AIAA-UTD-Comet-Rocketry/flight_tracker_RFM69/PCB docs/trackerPCB.step

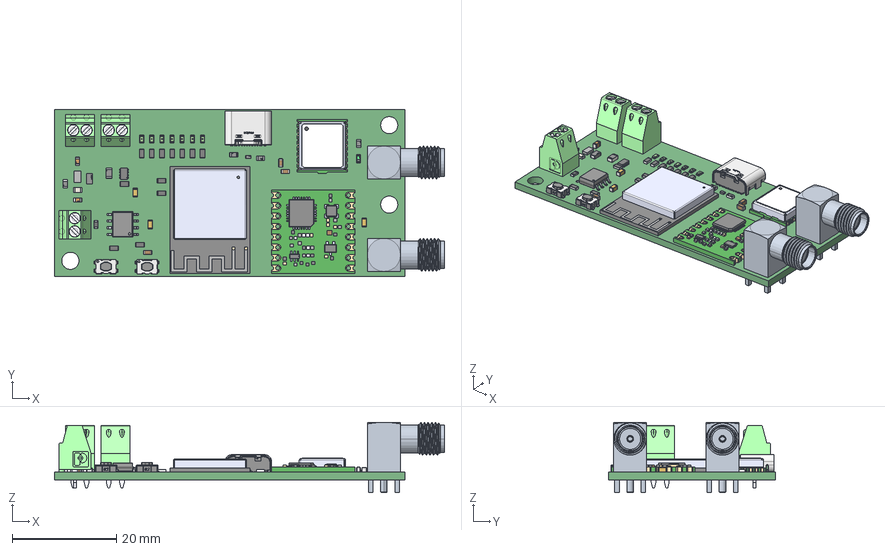
[picture p1: CAD file, 2026-07-08]
PCB docs/trackerPCB.step
74.9 x 32.1 x 13.5 mm
Stackpole Electronics Logo
Mid_Body x 12
Mark x 12
Texas Logo Yury
Texas Logo Yury - Copy
Notch
Molex
terminals x 4
logo x 4
top x 9
RFM69HCW-315S2--3DModel-STEP-56544
PinsArrayLR
pin 1 x 2
shield x 2
base x 2
Stackpole Logo adjustable
RES0603
Murata Logo 3
mpt_0.5-2-2.54 x 3
pcb x 7
lead x 7
lead -notch x 7
mark x 7
mark2 x 7
mark3 x 7
emitter x 7
CAPC1608X95N EIA 0603 x 3
Extruded x 4
ESP32-S3-MINI-1-N8
Sides
Core
Top
Vishay Logo
Pins
Murata logo 1mm
Cap_AVX_06036D476MAT2A_eec x 8
