AIAA-UTD-Comet-Rocketry/flight_tracker_RFM69/PCB docs/PDF/Schematic.PDF

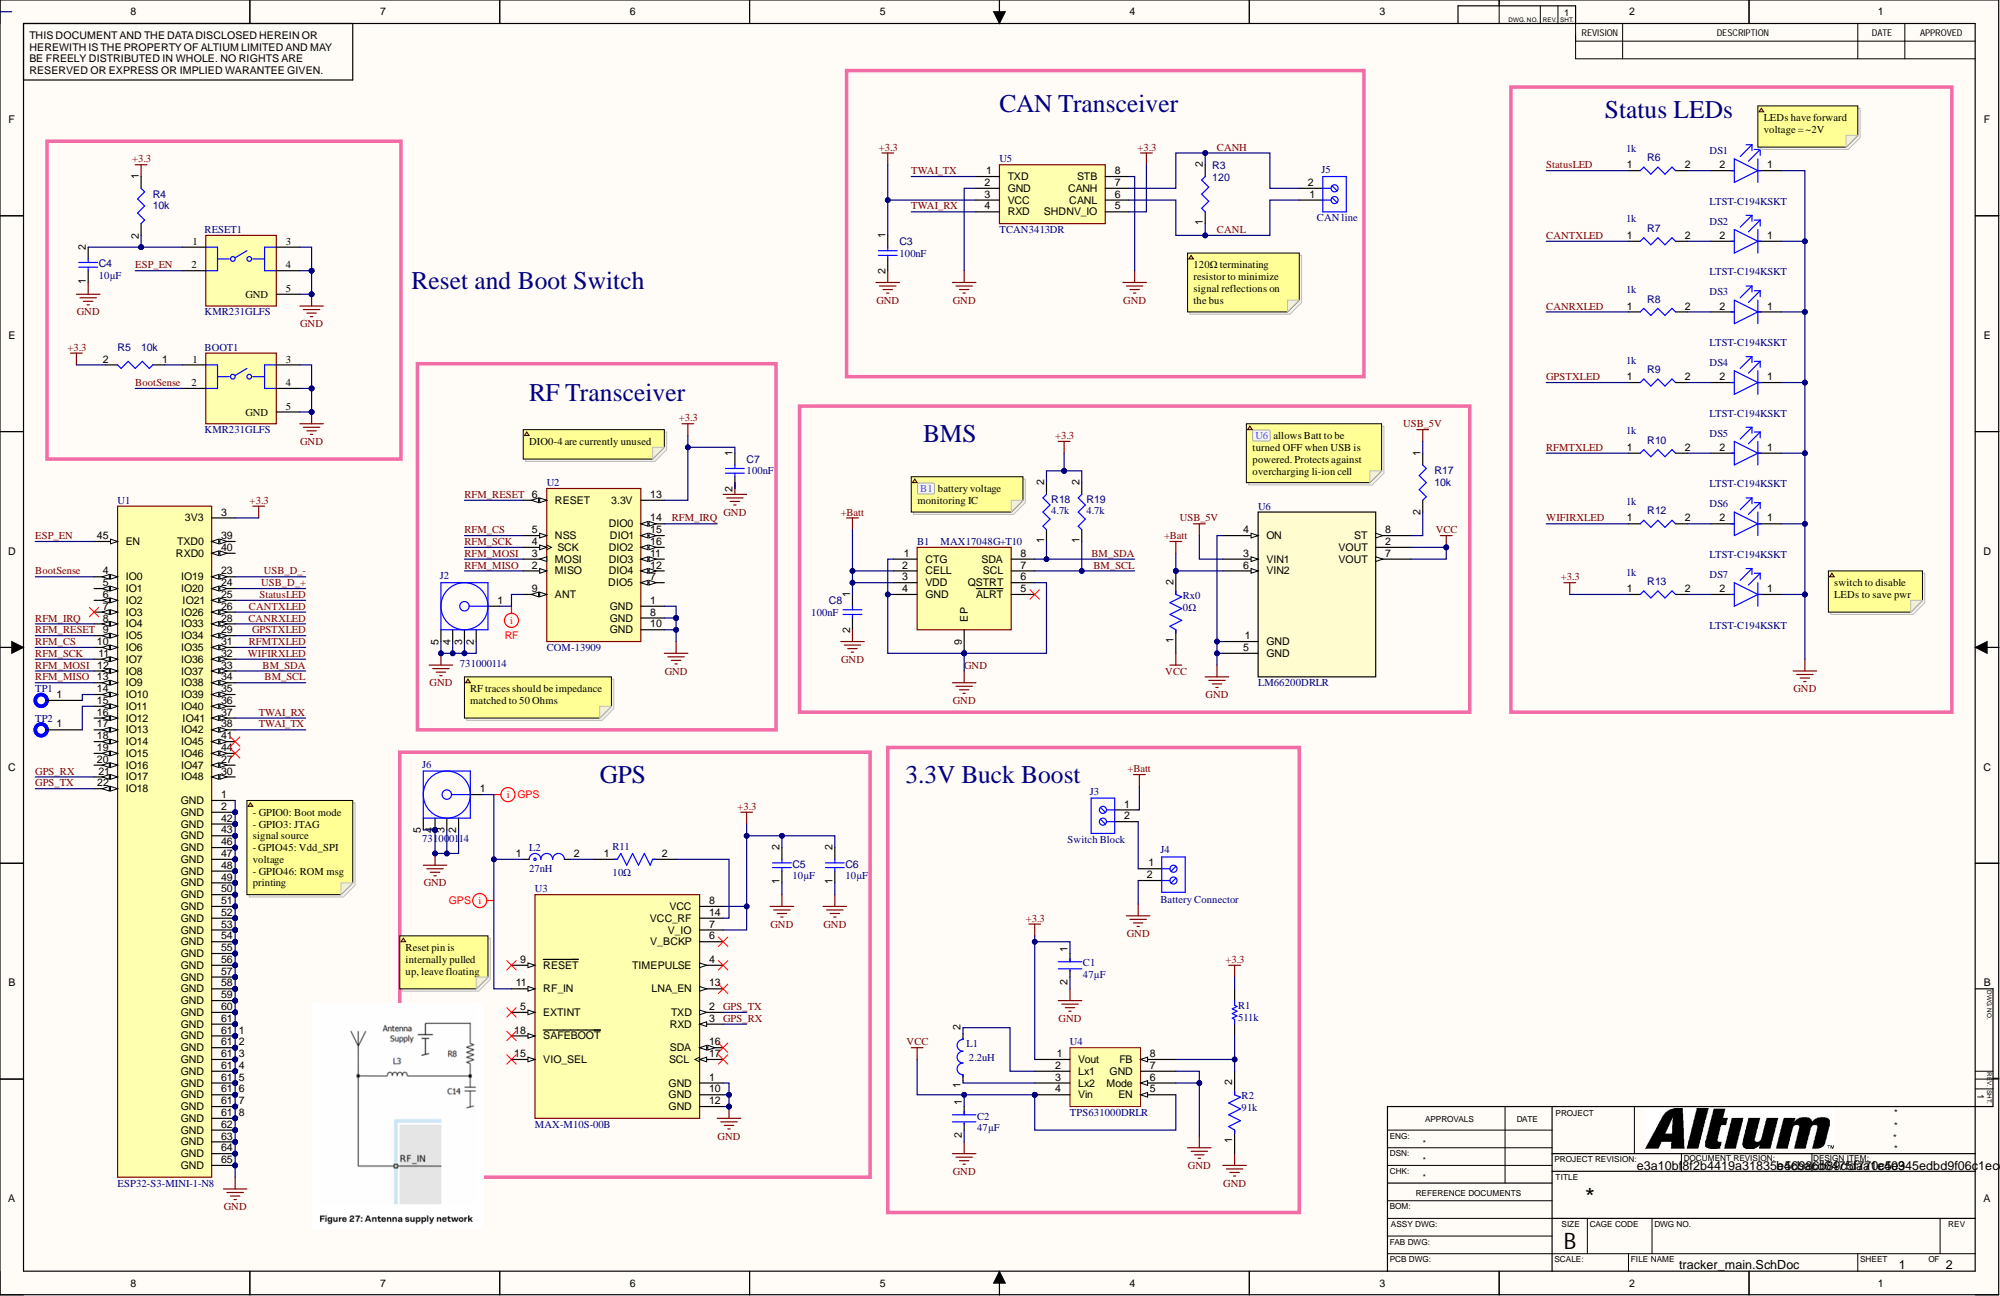
[picture p2: page 1]

DWG . N O . | R E V | 1 . S H T.

T H IS DOC U MEN T AN D T HE D ATA D ISCLOSED HEREI N OR HEREW I T H IS T HE PROPER TY OF ALT I U M LI M I TED AN D M AY BE F REELY D IST R IBU TED I N W HOLE. NO R IGH TS ARE RESERVED OR EXPRESS OR I MPLIED WARAN TEE GIVEN . | | REVISI ON | DESCRIPTI O N | DATE | APPROVED

Reset and Boot Switch

REV. SHT. DWG. NO.

ENG :
** DSN:

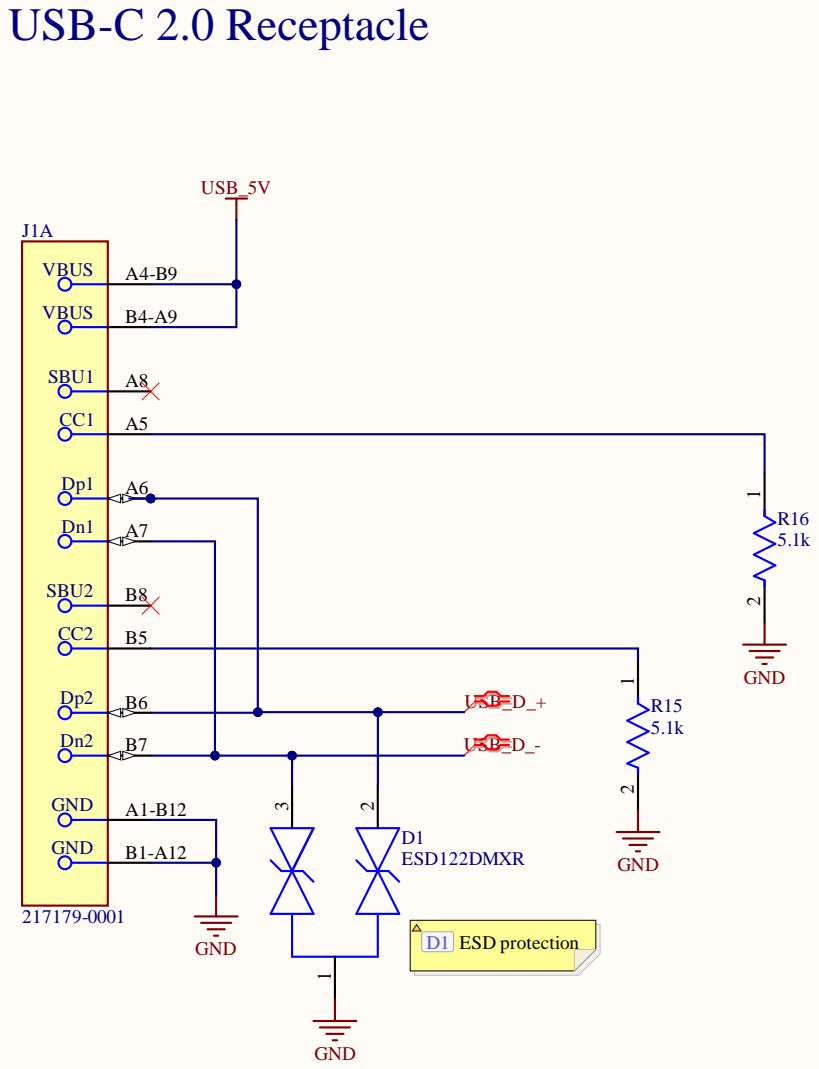
[picture p3: page 2]

USB-C 2.0 Receptacle GND VBUS
