AIAA-UTD-Comet-Rocketry/flight_tracker_RFM69/PCB docs/PDF/PCB Prints.PDF

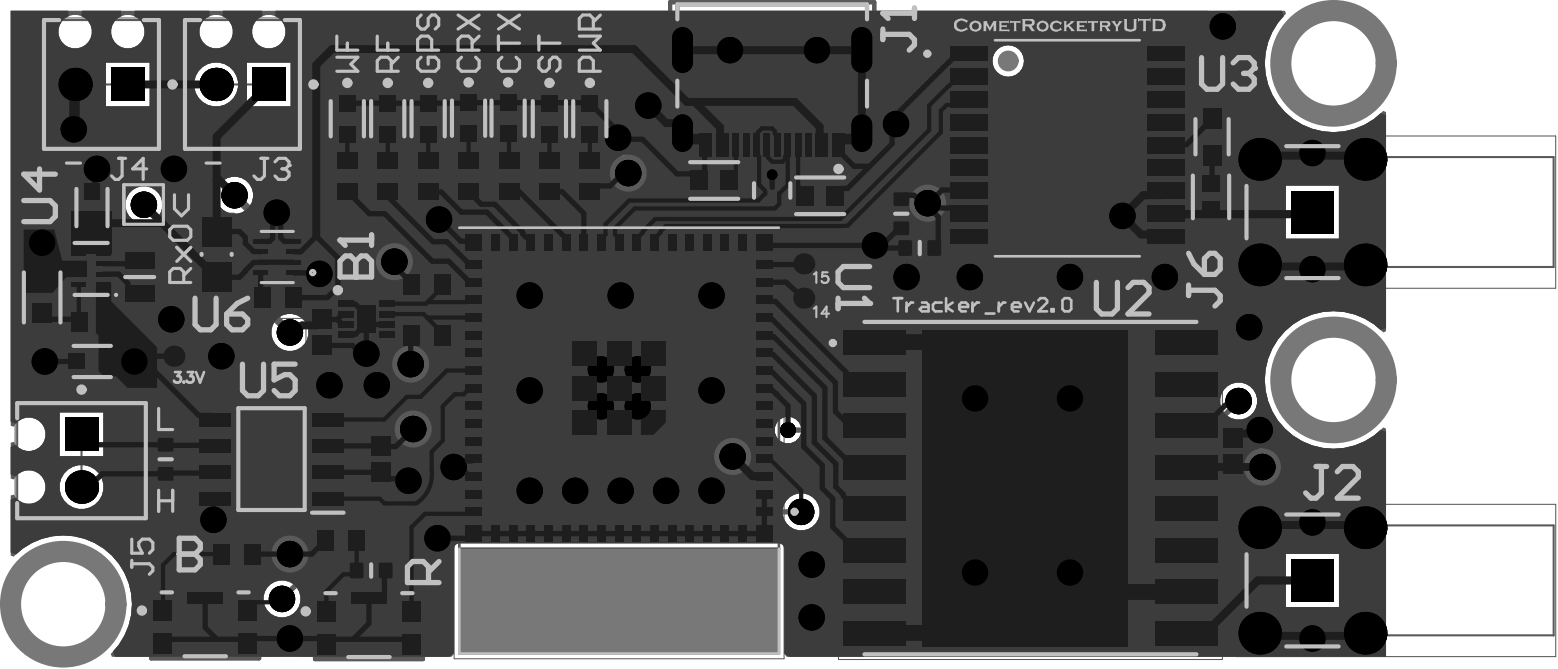
[picture p4: page 1]
