AIAA-UTD-Comet-Rocketry/flight_tracker_RFM69/(list of files, drawings)

Other design files:
PCB docs/Altium/25-26 Tracker.PrjPcb
PCB docs/Altium/PcbLib1.PcbLib
PCB docs/Altium/Schlib1.SchLib
PCB docs/Altium/tracker_main.SchDoc
PCB docs/Altium/tracker_usb_c.SchDoc
