AIAA-UTD-Comet-Rocketry/flight_tracker_RFM69/main/global_config.h

#ifndef GLOBAL_CONFIG_H
#define GLOBAL_CONFIG_H

/* BOARD GPIO PINOUT */
// GPS UART Pins
#define GPS_TX_PIN                 (gpio_num_t)17  // ESP32 RX (Connect to GPS TX)
#define GPS_RX_PIN                 (gpio_num_t)18  // TX not needed (GPS is sending data)

// RFM69 SPI Pins
#define RFM69_SCK                  (gpio_num_t)7 
#define RFM69_MISO                 (gpio_num_t)9 
#define RFM69_MOSI                 (gpio_num_t)8 
#define RFM69_CS                   (gpio_num_t)6 
#define RFM69_IRQ                  (gpio_num_t)4   // G0 Pin in Breakout board 
#define RFM69_RST                  (gpio_num_t)5 

// CAN/TWAI Pins
#define TWAI_TX_GPIO               (gpio_num_t)42  // ESP32 -> Transceiver TXD
#define TWAI_RX_GPIO               (gpio_num_t)41  // Transceiver RXD -> ESP32

// LED Status Pins
#define LED_GPS_PIN                (gpio_num_t)34
#define LED_RF_PIN                 (gpio_num_t)35
#define LED_CANRX_PIN              (gpio_num_t)33
#define LED_CANTX_PIN              (gpio_num_t)26
#define LED_WIFI_PIN               (gpio_num_t)36
#define LED_STATUS_PIN             (gpio_num_t)21

// Fuel Gauge I2C Pins
#define I2C_MASTER_SCL_IO          (gpio_num_t)38         /*!< gpio number for I2C master clock */
#define I2C_MASTER_SDA_IO          (gpio_num_t)37         /*!< gpio number for I2C master data  */


#define CALLSIGN            "KJ5LPG"
#define IREC_TEAM_NUM       308

// Transceiver config:
static const uint8_t sw[] = {0x10, 0xAF};        // sync word — must match receiver
#define RADIO_FREQ          441.610   // MHz (Range from 431.0 - 510.0)
#define BIT_RATE            4.8     // kbps - controls how fast data can be sent
#define DEVIATION_FREQ      5       // kHz - modulation index needs to be 2: 5/1.2 ~ 2
#define RX_BANDWITH         125.0      // kHz - narrow range = less noise but higher sensitivity (BW = 2 × deviation + bit_rate)
#define OUTPUT_PWR          20      // dBM - 20 is max power
#define PREAMBLE_LENGTH     32      // bits - affects how fast receiver locks

// GPS config:
#define GPS_UART_NUM        UART_NUM_1  // Changed from UART_NUM_0 to avoid conflict with console
#define GPS_BAUD_RATE       9600    // NEO-6M default
#define BUF_SIZE            1024
#define GPS_APRS_PKT_DELAY  3000       // 3 seconds

// Wifi config:
static const uint8_t ESPNOW_SENDER_MAC[6] = {
     0xe8, 0xf6, 0x0a, 0x8d, 0xba, 0x54 
    }; // Payload ESP32

#define ESPNOW_CHANNEL        6             // must match sender’s channel
#define ESPNOW_IFACE          WIFI_IF_STA   // WIFI_IF_STA or WIFI_IF_AP
#define ESPNOW_RX_QUEUE_LEN   16            // Queue sizing for received frames
#define ESPNOW_RX_MAX_LEN     32            // 32 bytes typical payload

// CAN Config
#define TLM_ALL_CHUNKS  0x3F         // bits 0-5 set = all 6 chunks received
#define TLM_BASE_ID     1400
#define TLM_CHUNKS      6

#endif // global_config.h
