AIAA-UTD-Comet-Rocketry/flight_tracker_RFM69/(commit log)

2025-09-27 Replaced si446x driver with RFM69 from 2024 flight tracker
    [AX_25.cpp, aprs.cpp, aprs.h, radiolib_esp32s3_hal.hpp, tracker_main.cpp]
2025-10-04 Fixed GPS UART
2025-10-10 Changed SPI Pins
2025-10-23 Update tracker_main.cpp
    Updated CAN Bus Config
2025-10-23 Update tracker_main.cpp
    Added CAN/TWAI bring-up, defined TX/RX pins and bitrate, initialized the ESP32 TWAI
    Launched TX/RX tasks
2025-10-24 print payload data
2025-10-24 Update tracker_main.cpp
    Simplified initializations, made some edits, CAN Bus Initialization void_().
2025-10-29 properly print data
2025-10-29 Update README with prerequisites and new links
    Added prerequisites and additional documentation links for ESP32, GPS, and CAN.
2025-11-13 add filter for mac addr
2025-12-05 rfm69 spi gpio change
2026-02-20 remove unused rf gpio pin
2026-02-27 Implement CAN RX task for receiving CAN frames
2026-04-08 add led status task
2026-04-18 Added missing LED pin
    [led_status.c, led_status.h, tracker_main.cpp]
2026-04-18 Changes to LED driver
2026-04-28 re-arrange files
    [25-26 Tracker.PrjPcb, PcbLib1.PcbLib, Schlib1.SchLib, tracker_main.SchDoc, tracker_usb_c.SchDoc]
2026-04-28 add voltage reading to gps aprs packet
2026-07-08 Create CAD
2026-07-08 pcb pdf
